JonesyPi/FormerGlove/README.md

# FormerGlove

Daniel:

First Test:

Arduino IDE

Board:
Nicla Sense ME

Board Manager:
Arduino Mbed OS Nicla Boards

This code changes the colour of the Nicla's LED periodically, so I used it just to check if the Nicla works correctly.

Connecting to Periphials via BLE:

Libraries:
ArduinoBLE

This is a minimalized code to connect the Nicla Sense to a periphial and toggle the built-in LED. I'm using LightBlue on iOS to connect and write a hex value (00 -> LED off; 01 -> LED on)

Testing the Sensors:

Libraries:
Arduino
Arduino_BHY2

Here, I tested the IMU sensor of the Nicla Sense, which includes an accelerometer and a gyroscope. These will be used to measure the movement and rotation of the glove.

Transfering Sensor Data between Niclas:

On the right glove, I read data periodically and send it to the left glove via BLE, on which I print out the sensor data of both hands simultaneously. It is important to search the periphial by name manually as the scanForName function is inprecise with custom devices. I also implemented a one second delay after starting the scan, which is necessary for the initialisation.

Running code from VS Code:

I changed the structure to have a FOlder named src with all codes in it, as this is the standard on PlatformIO. After that, I created different environments for each hand in platformio.ini and added a src filter so it uploads the right code.
