JonesyPi/FormerGlove/Silajdzic_Jones_Plakat.pptx

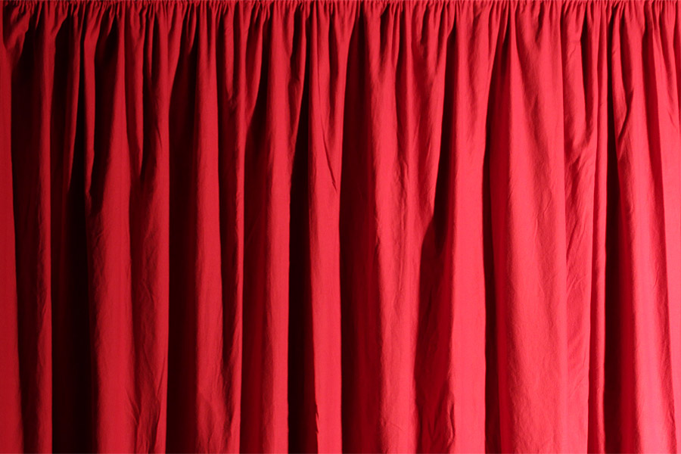
[picture p23: figure]
Vorhang auf – Kino-Vorhänge finden und aufhängen | Heimkino Praxis

## Slide 2

Former Glove

DIPLOMARBEIT 2025/26

Stärke beginnt mit richtiger Form

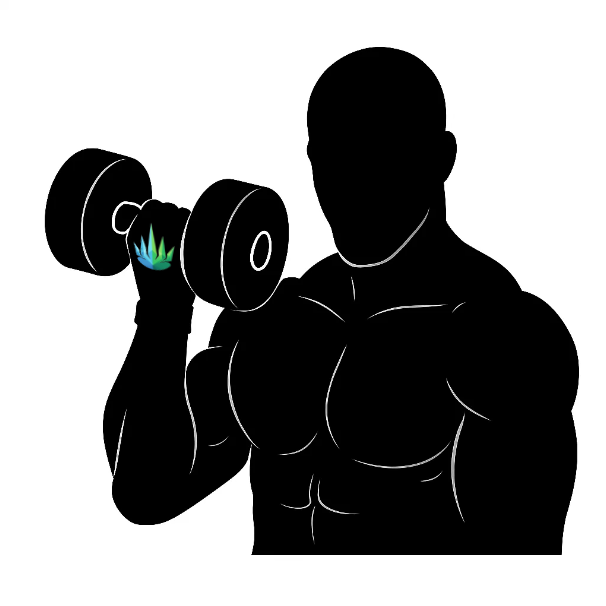
[picture p24: figure]

Hauptfunktionen:
- KI-Feedback zur Ausführung
- Zählt Wiederholungen & speichert Fortschritte
- Übersicht über vergangene Workouts

Ziel:
Richtiges und sicheres Training – für Anfänger*innen und Fortgeschrittene.

Nutzen:
Spart Zeit, vermeidet Verletzungen, verbessert die Trainingsform.

PROJEKTANTEN

KLASSE

BETREUER

Dipl.-Ing. Mario Preishuber

Kevin Silajdzic
Daniel Jones

5 AHELS
