JonesyPi/FormerGlove/Kostenplan.xlsx

Projekt: | Former Glove
Datum: | 2025-09-17
Benennung |  | Kosten-Plan | Kosten-Ist
Mikrocontroller |  | €110.00 | €110.00
Trainingshandschuhe |  | €20.00 | €20.00
Akkus |  | €24.00 | €24.00
Gesamt |  | €154.00 | €154.00
