JonesyPi/FormerGlove/3D/NiclaSchlaufe v10.stl

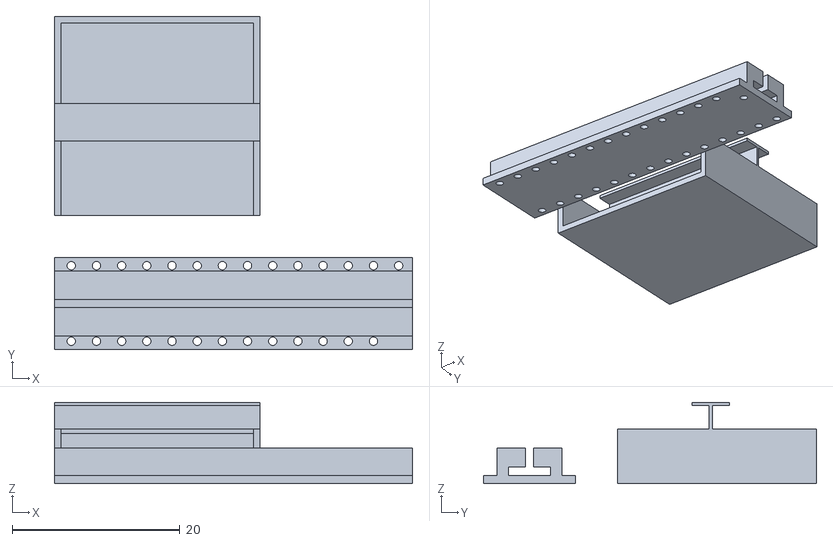
[picture p25: CAD file, 2025-11-14]
3D/NiclaSchlaufe v10.stl
42.7 x 39.7 x 9.70
