JonesyPi/FormerGlove/3D/NiclaSchlaufe v7.3mf

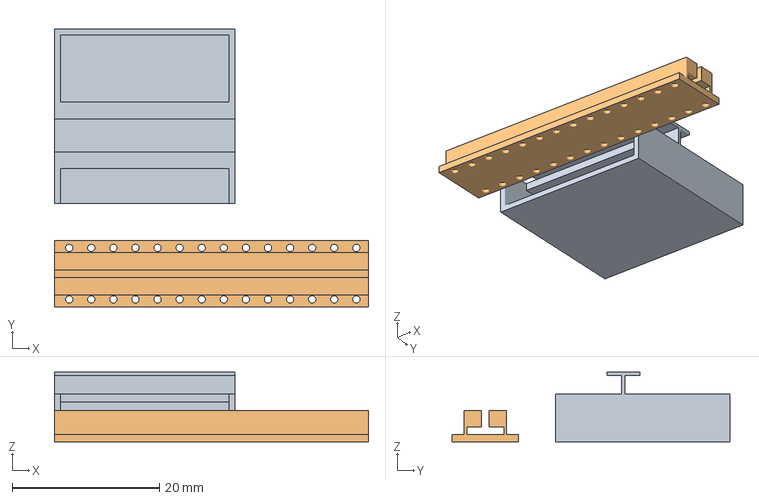
[picture p26: CAD file, 2025-11-06]
3D/NiclaSchlaufe v7.3mf
42.6 x 37.7 x 9.50 mm
Körper1
Körper4
