JonesyPi/FormerGlove/3D/AkkuGehäuse v6.3mf

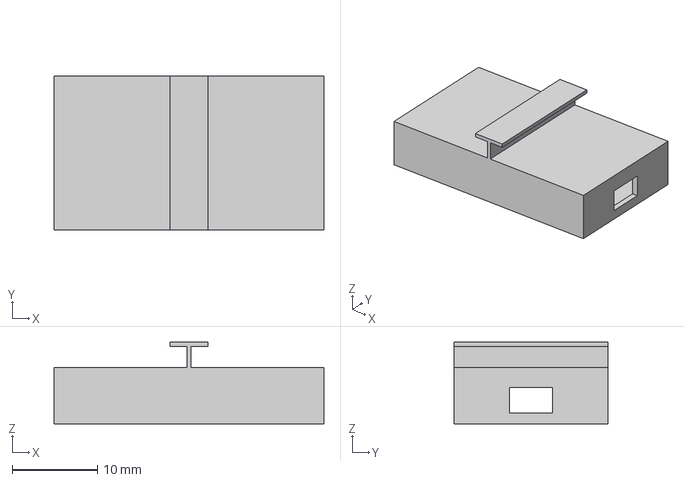
[picture p27: CAD file, 2025-11-06]
3D/AkkuGehäuse v6.3mf
31.7 x 18.1 x 9.60 mm
