JonesyPi/FormerGlove/3D/Akku v5.stl

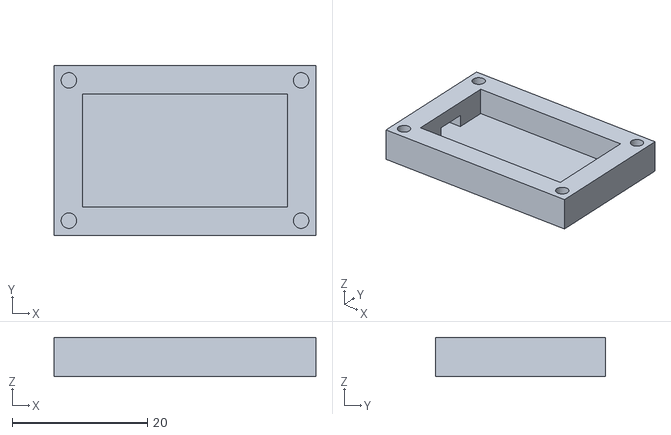
[picture p28: CAD file, 2025-09-24]
3D/Akku v5.stl
38.8 x 25.1 x 5.80
