JonesyPi/FormerGlove/3D/NiclaSenseME v8.stl

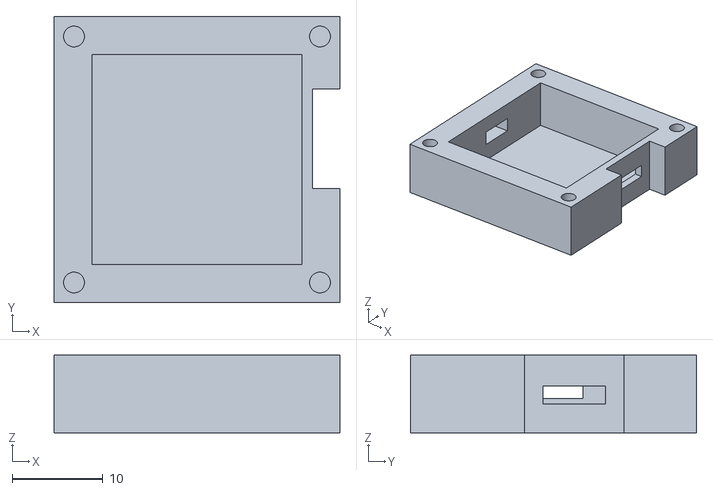
[picture p29: CAD file, 2025-09-24]
3D/NiclaSenseME v8.stl
31.5 x 31.5 x 8.55
