JonesyPi/FormerGlove/3D/AkkuAbdeckplatte v3.stl

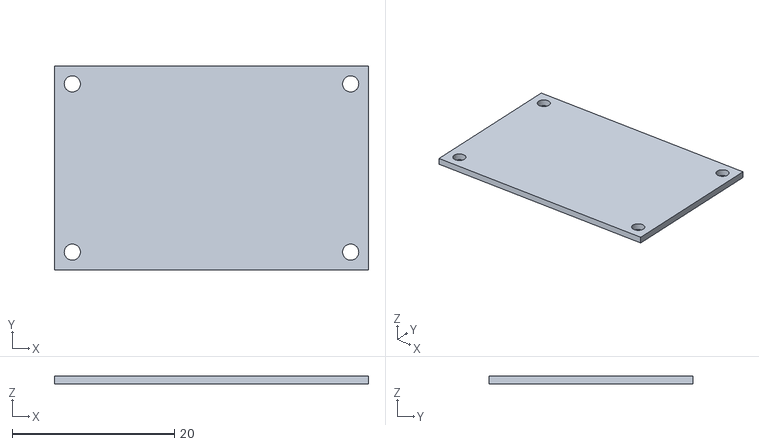
[picture p30: CAD file, 2025-09-24]
3D/AkkuAbdeckplatte v3.stl
38.8 x 25.1 x 1.00
