JonesyPi/FormerGlove/3D/NiclaSenseMEAbdeckplatte v4.stl

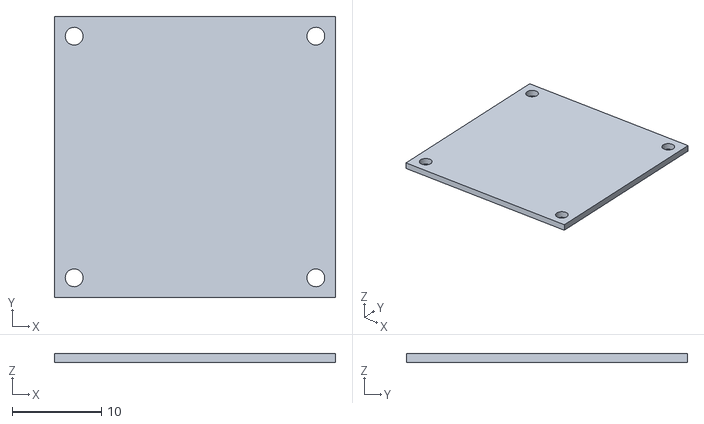
[picture p31: CAD file, 2025-09-24]
3D/NiclaSenseMEAbdeckplatte v4.stl
31.5 x 31.5 x 1.00
