JonesyPi/FormerGlove/3D/NiclaSchlaufe v9.stl

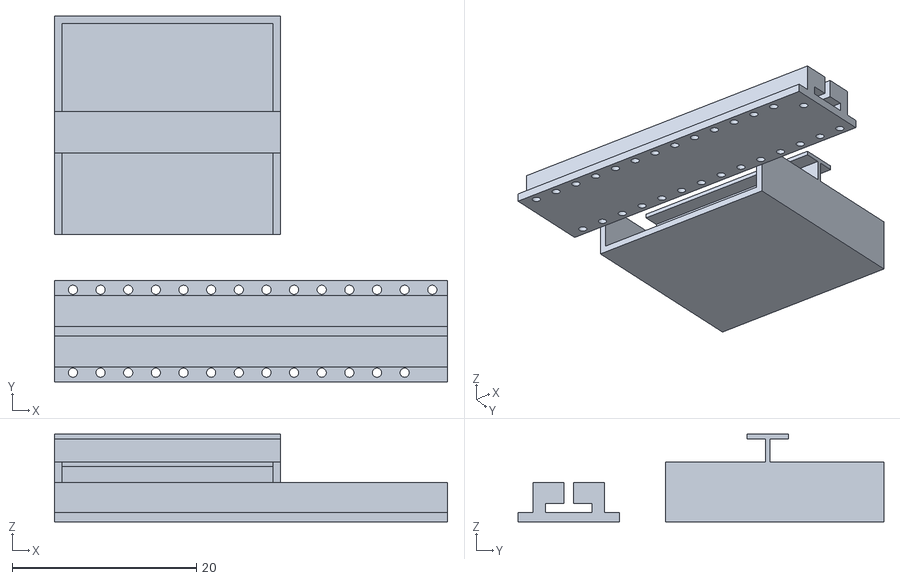
[picture p32: CAD file, 2025-11-14, an earlier design]
3D/NiclaSchlaufe v9.stl
42.7 x 39.7 x 9.50
