JonesyPi/FormerGlove/3D/AkkuGehäuse v5.3mf

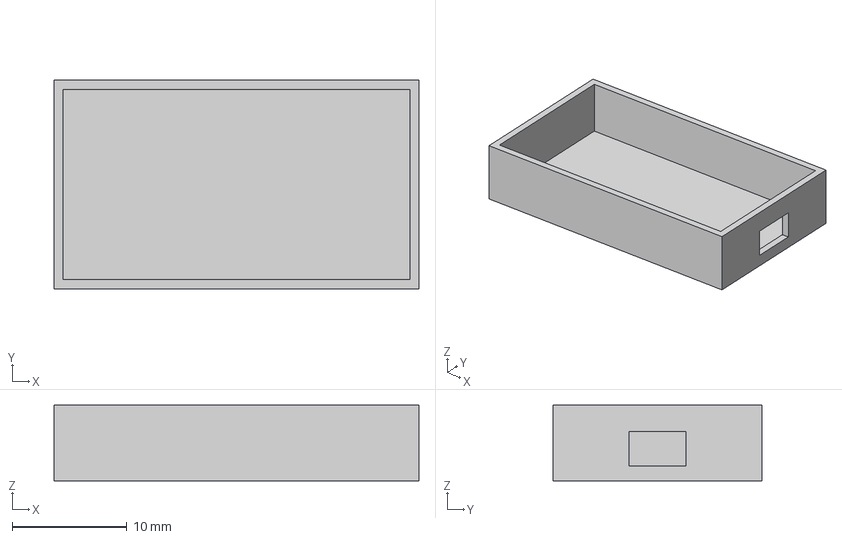
[picture p33: CAD file, 2025-11-06, an earlier design]
3D/AkkuGehäuse v5.3mf
31.7 x 18.1 x 6.60 mm
