JonesyPi/FormerGlove/3D/NiclaSchlaufe v5.3mf

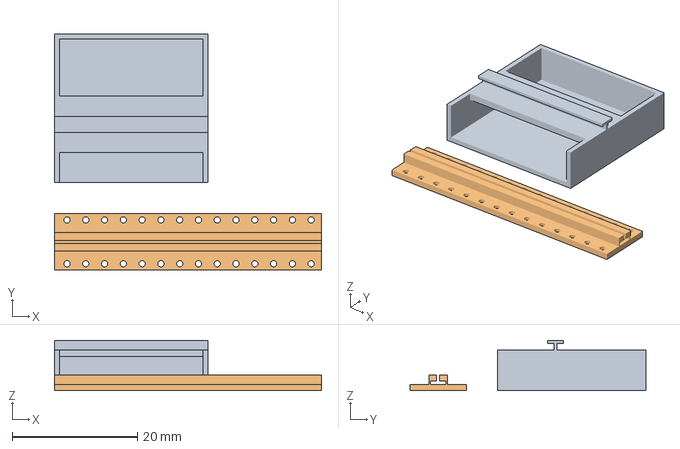
[picture p34: CAD file, 2025-10-15, an earlier design]
3D/NiclaSchlaufe v5.3mf
42.6 x 37.7 x 8.00 mm
Körper1
Körper4
