JonesyPi/FormerGlove/3D/AkkuGehäuse v4.3mf

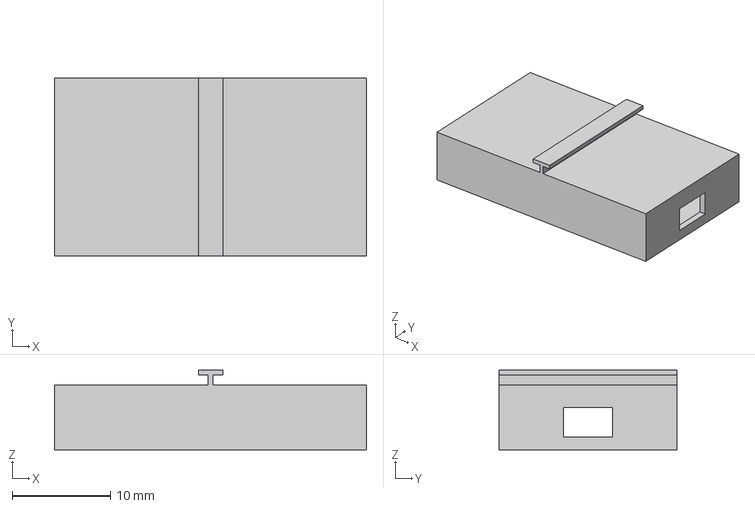
[picture p35: CAD file, 2025-10-08, an earlier design]
3D/AkkuGehäuse v4.3mf
31.7 x 18.1 x 8.10 mm
