JonesyPi/FormerGlove/3D/NiclaSchlaufe v4.3mf

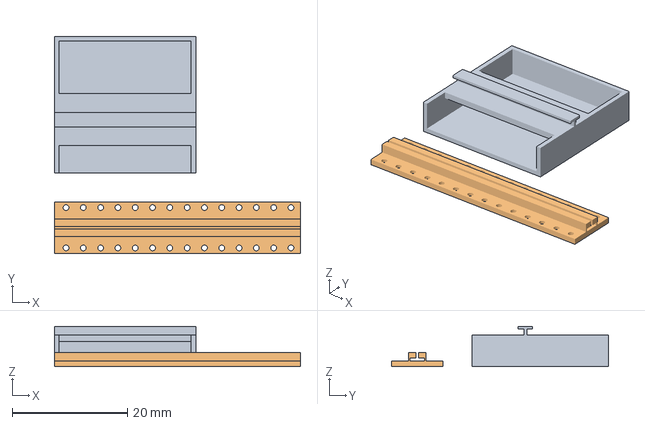
[picture p36: CAD file, 2025-10-08, an earlier design]
3D/NiclaSchlaufe v4.3mf
42.6 x 37.7 x 7.00 mm
Körper1
Körper4
