JonesyPi/FormerGlove/(list of files, cad)

Other CAD files:
3D/NiclaSchlaufe v9.f3d
