JonesyPi/FormerGlove/edge_impulse_forwarder/test.csv

data
30
