JonesyPi/FormerGlove/Projekttagebuch.docx

Projekttagebuch:

13.06.2025:

Daniel:
Nicla LED Test und Recherche über BLE (3 Stunden)

Kevin:
Flutter & Android Studio Einstieg (3 Stunden)

15.06.2025:

Daniel:
Nicla über BLE verbinden und IMU-Sensoren testen (3 Stunden)

16.06.2025:

Daniel:
Sensordaten zwischen Niclas teilen (3 Stunden, 1 Stunde in Schule)

Kevin:
Flutter lernen (1 Stunde in Schule)
