JonesyPi/FormerGlove/(commit log)

2025-06-15 Testing the Sensors
2025-06-16 Transfering Sensor Data between Niclas
2025-09-24 Switch to VS Code
2025-10-15 Battery charging function
2025-11-14 Charge battery over Nicla
